Jaival111/Smart-Tap-Monitor/README.md

# Smart-Tap-Monitor

[Demo video](https://drive.google.com/file/d/1t6mX3QaEuzqUU_DgrgPJtbW8TfgVl9iE/view?usp=sharing)
